gerrieuae/XY-SK60-DPS-enclosure/pictures/DPS_topII.jpg

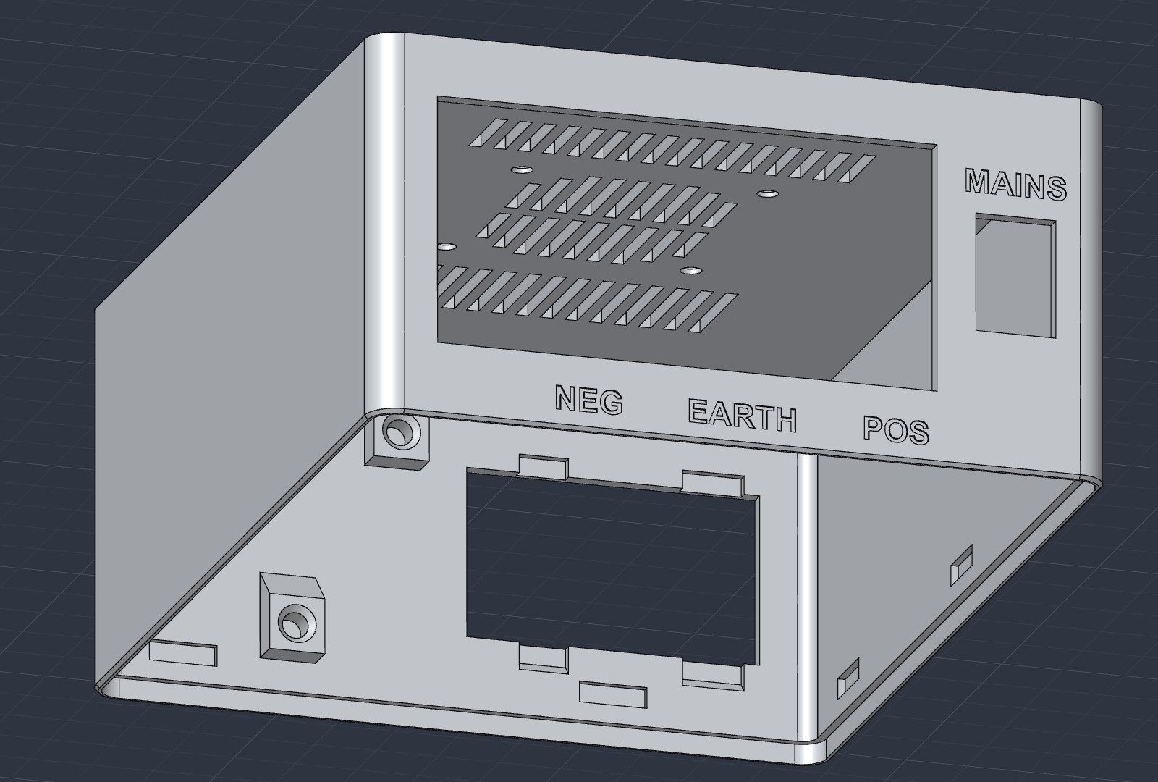
pictures/DPS_topII.jpg
