gerrieuae/XY-SK60-DPS-enclosure/Enclosure_Bottom.3mf

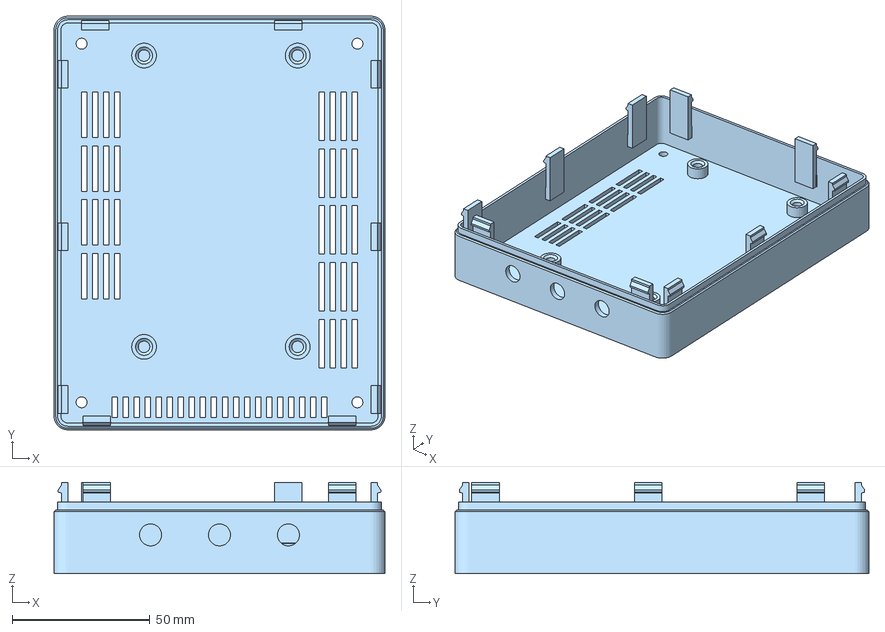
[picture p8: CAD file, 2026-11-08]
Enclosure_Bottom.3mf
120.0 x 150.0 x 33.0 mm
