gerrieuae/XY-SK60-DPS-enclosure/stepFiles/IEC-C14_17362.stp

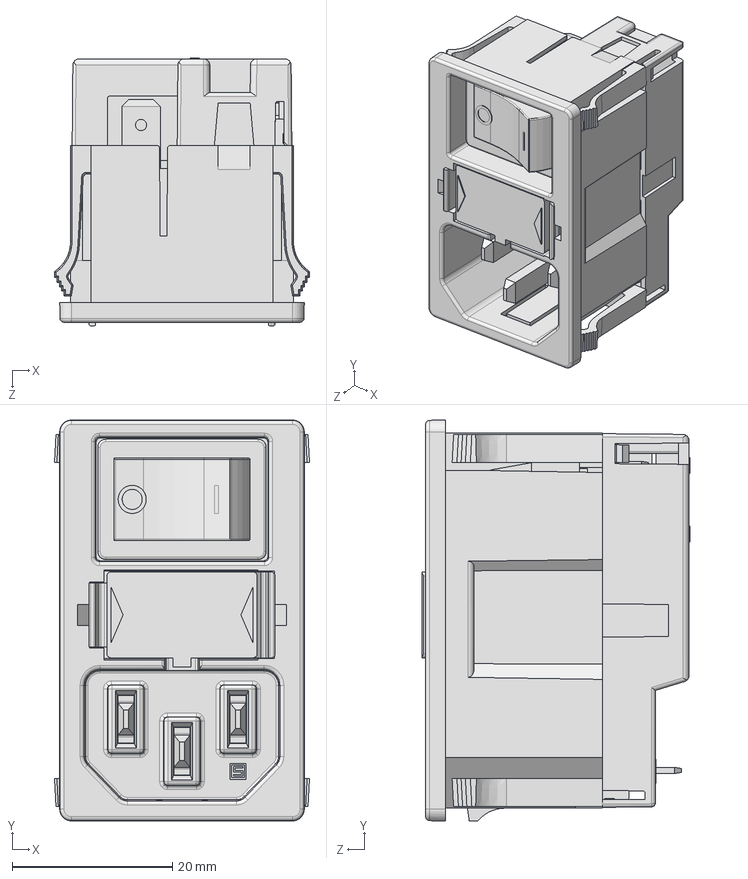
[picture p9: CAD file, 2026-11-04]
stepFiles/IEC-C14_17362.stp
31.8 x 50.0 x 33.4 mm
