gerrieuae/XY-SK60-DPS-enclosure/clipTest_Top.3mf

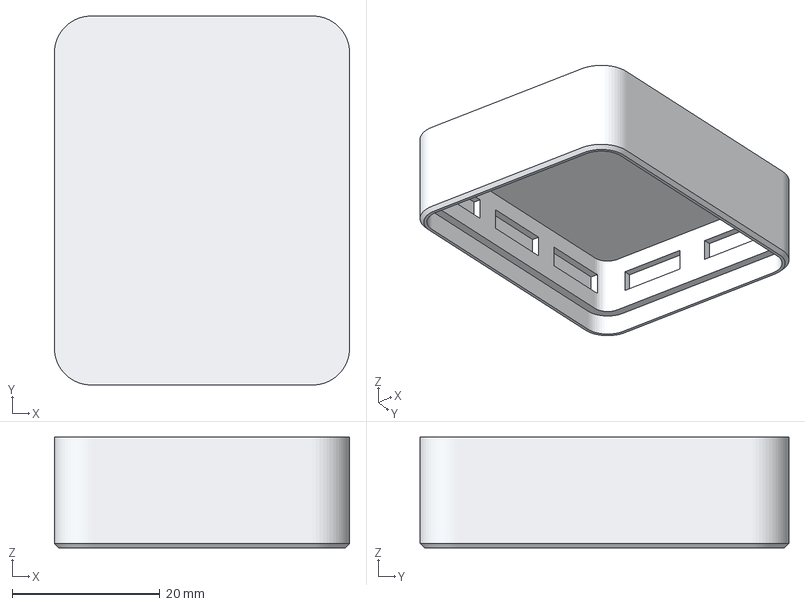
[picture p10: CAD file, 2026-11-08]
clipTest_Top.3mf
40.0 x 50.0 x 15.0 mm
