gerrieuae/XY-SK60-DPS-enclosure/clipTest_Bottom.3mf

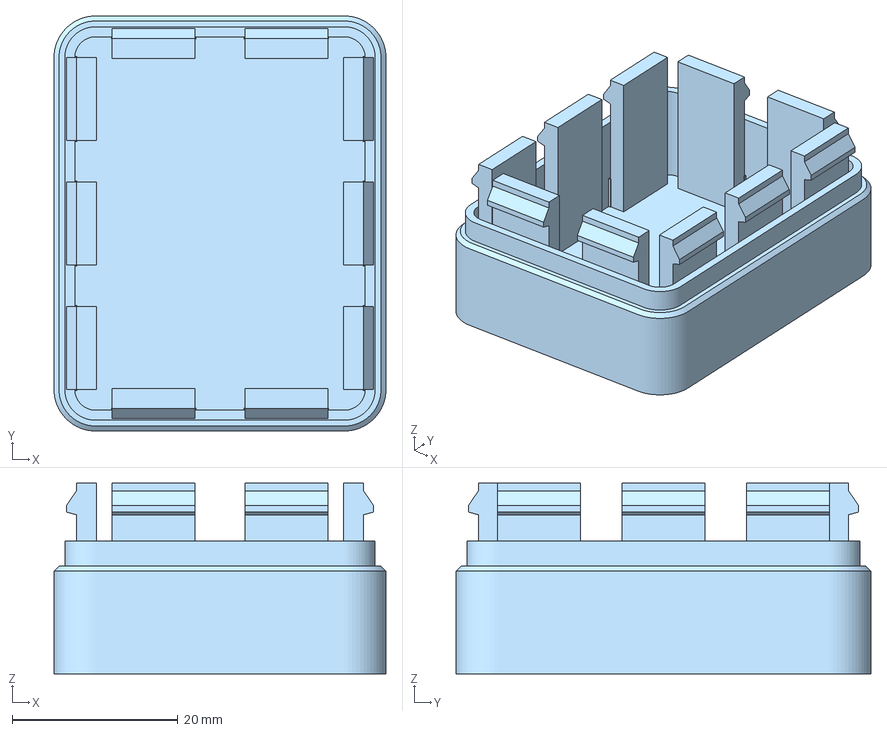
[picture p11: CAD file, 2026-11-08]
clipTest_Bottom.3mf
40.0 x 50.0 x 23.0 mm
