gerrieuae/XY-SK60-DPS-enclosure/stepFiles/IEC-C14_3521819.stp

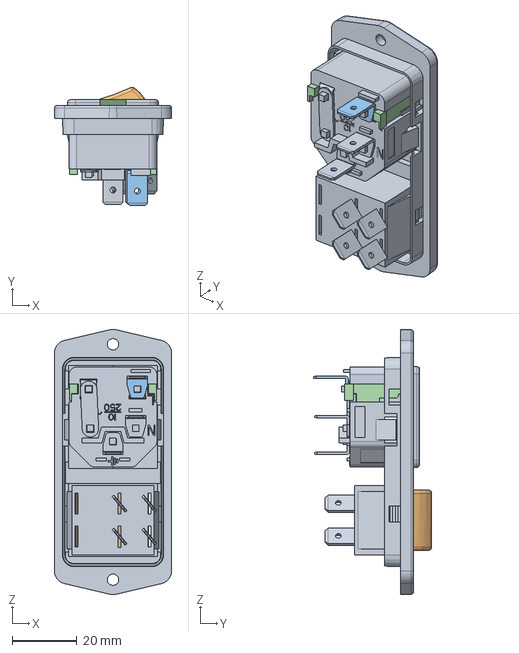
[picture p12: CAD file, 2026-11-04]
stepFiles/IEC-C14_3521819.stp
36.1 x 36.5 x 81.6 mm
