gerrieuae/XY-SK60-DPS-enclosure/Enclosure_Top.3mf

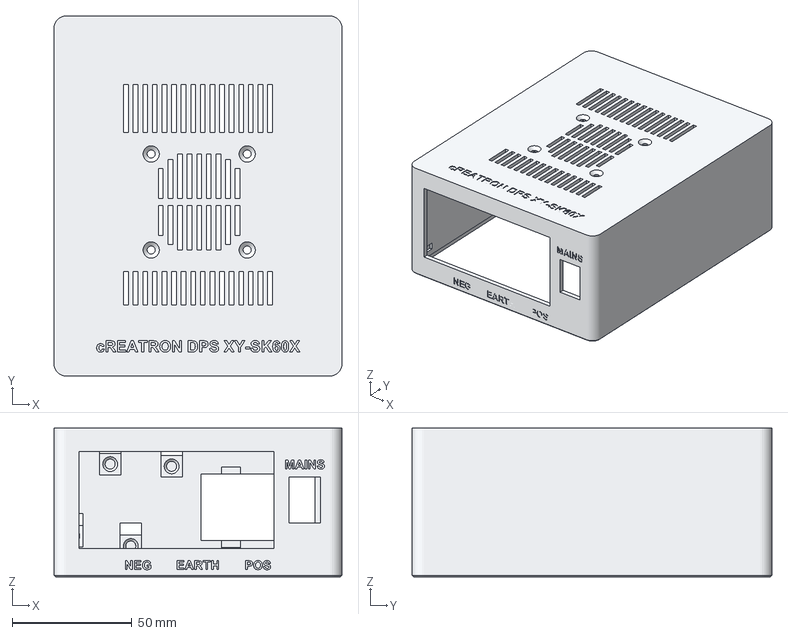
[picture p13: CAD file, 2026-11-08]
Enclosure_Top.3mf
120.0 x 150.0 x 62.0 mm
