gerrieuae/XY-SK60-DPS-enclosure/stepFiles/DC5010_7.stp

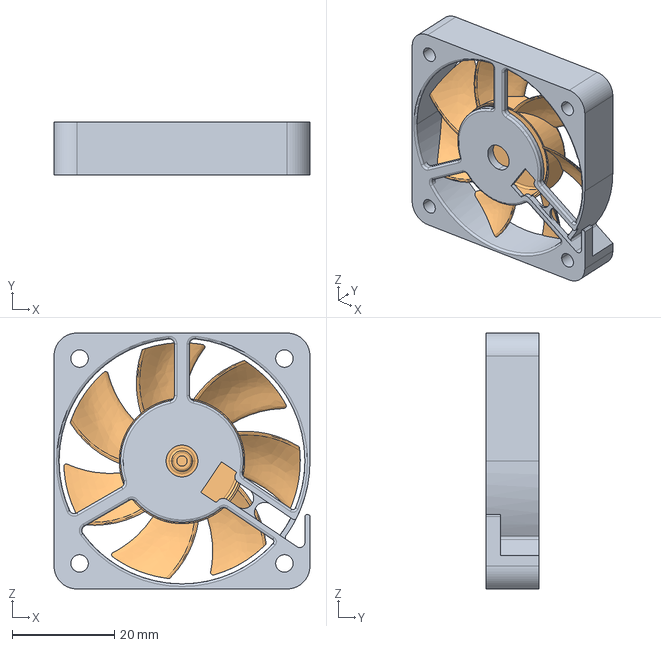
[picture p14: CAD file, 2026-11-01]
stepFiles/DC5010_7.stp
50.0 x 10.4 x 50.0 mm
DC5010-HUO-20211027_4
DC5010-7IPM-20211027_1
