gerrieuae/XY-SK60-DPS-enclosure/insertTest.3mf

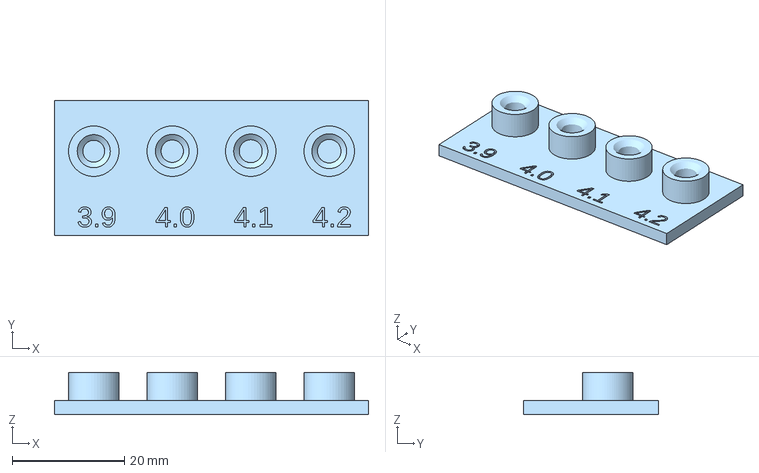
[picture p15: CAD file, 2026-11-08]
insertTest.3mf
56.0 x 24.0 x 7.50 mm
