gerrieuae/XY-SK60-DPS-enclosure/stepFiles/banana_4mm_black-ST-351B V1 - BLACK.STEP

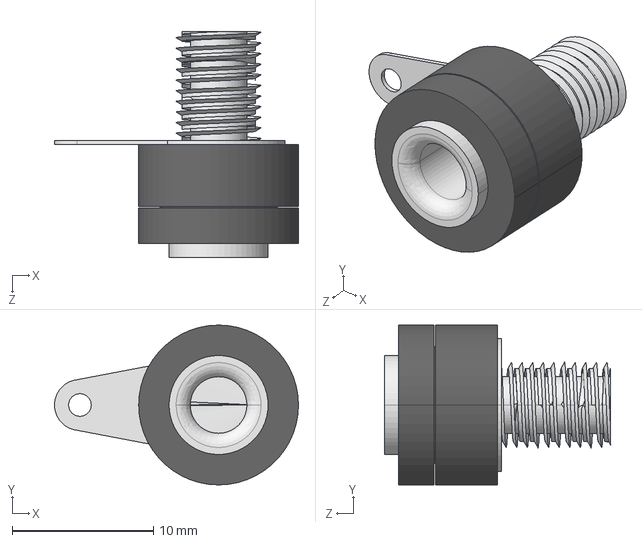
[picture p16: CAD file, 2026-11-01]
stepFiles/banana_4mm_black-ST-351B V1 - BLACK.STEP
17.2 x 11.3 x 16.0 mm
Insulator
Metal
