gerrieuae/XY-SK60-DPS-enclosure/stepFiles/LM2596_DC-DC_CONVERTER.STEP

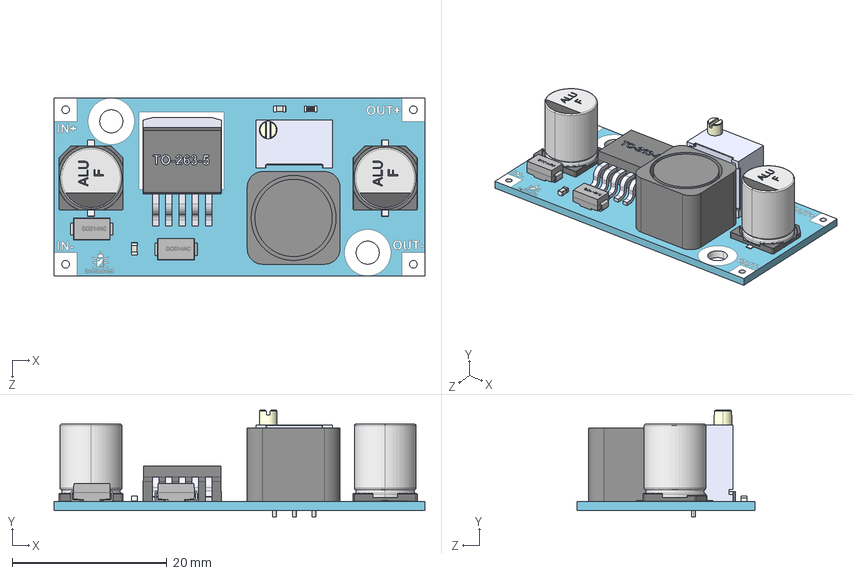
[picture p17: CAD file, 2026-11-01]
stepFiles/LM2596_DC-DC_CONVERTER.STEP
48.0 x 13.8 x 23.0 mm
User Library-DC-DC MODULE LM2596s_User Library-TO-263-5_TO-263-5_Body_1
User Library-DC-DC MODULE LM2596s_User Library-TO-263-5_TO-263-5_Leads_1
User Library-DC-DC MODULE LM2596s_User Library-TO-263-5_TO-263-5_Marking_1
User Library-DC-DC MODULE LM2596s_C0603 x 2
User Library-DC-DC MODULE LM2596s_User Library-ALU-F_Pins_1 x 2
User Library-DC-DC MODULE LM2596s_User Library-ALU-F_Fuss_1 x 2
User Library-DC-DC MODULE LM2596s_User Library-ALU-F_K_X_F6rper_1 x 2
User Library-DC-DC MODULE LM2596s_User Library-ALU-F_Beschriftung_1 x 2
User Library-DC-DC MODULE LM2596s_R0603
BASE_LM2596
INDUCTOR_LM2596
POT_LM2596
DIODE_LM2596 x 2
