gerrieuae/XY-SK60-DPS-enclosure/(commit log)

2026-11-01 Initial commit: 36 V bench PSU enclosure (110 x 150 x 85)
    SolidCraft design of a 3D-printed two-part enclosure for an AC-DC2416
    36 V supply with XY-SK60 controller, Schurter C14 inlet, front mains
    rocker, ST-351B banana sockets and a 5 V fan on an LM2596HV.
    Includes component models, print-ready 3MF halves, spec.md and README.
    [DC5010_7.stp, Enclosure_Bottom.3mf, Enclosure_Top.3mf, LM2596_DC-DC_CONVERTER.STEP, banana_4mm_black-ST-351B V1 - BLACK.STEP, try1.step]
2026-11-01 Add 120 x 150 x 85 design, 15x21 rocker, and pre-parametric backup
    - PSU_Enclosure_120x85.sc: current main design (IEC cutout 48.1 x 28.1)
    - Rocker_Switch_15x21.sc: measured rocker switch model
    - backup/: snapshot of the 120x85 design before the parametric rework
    - README/spec updated for the 120 mm wide layout
2026-11-01 Make the enclosure parametric (v3.1), geometry unchanged at 120 x 150 x 85
    - Split on a construction plane at split_z; lip and groove sketches
    fully dimensioned from enc_w, enc_d, wall, corner_r, lip_t, lip_clr
    - Bosses replaced by expression-placed standoff cylinders (psu_*, lm_*)
    - Feet, fan screws, all six vent fields, six clips with hooks and
    pockets derived from enc_w, enc_d, split_z, wall and the fan
    - 52 new user parameters, defaults reproduce the previous geometry
    (both enclosure bodies measure identical to backup/)
    - spec.md section 7 rewritten: parameter groups and what still does
    not follow a size change (imported component placement)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
2026-11-01 Derive side floor vent counts from the PSU standoff clearance
    fv_right_n and fv_left_n (replacing fv_side_n) count the slots that fit
    between the outer wall and the PSU standoff plus fv_side_clear, so the
    side vent fields shrink with enc_w instead of running into the posts.
    4 per side at 120 wide, unchanged geometry.
2026-11-01 Rebuild lip and groove from two splits so every size rebuilds
    The lip was an extruded ring joined onto the bottom half with faces
    lying exactly on the cavity wall; that union failed at widths 100-110
    and depth 135 depending on unrelated features. Now the box is split at
    split_z + lip_h (Lip_Top_Plane) and at split_z (Split_Plane); the ring
    between them is trimmed to the lip and joined to the bottom, a copy is
    trimmed to the outer wall and joined to the top after the groove cut.
    All booleans meet a face exactly or cut inside material.
    Verified: no feature errors at the defaults and at W 100/105/110/140,
    D 120/135/180, H 70/110, split 20/28, wall 2/3, corner 4/7. Default
    bodies within 2 mm3 o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
2026-11-01 Square gusseted LM2596 posts and a recessed name on the lid
    - LM2596 posts are now 6 x 6 square, 5 long, with a 45 degree gusset
    on the lid side running 5 mm up the rear wall, so the top prints
    lid-down without support (lm_boss_d renamed lm_boss_w)
    - "cREATRON DPS XY-SK60X" in Arial Bold, 4.7 mm capitals, centred,
    baseline 10 mm behind the front wall, recessed 0.3 mm into the lid
    (name_text, name_h, name_front, name_depth, name_y)
    - No feature errors; rebuilds at width 110 and depth 135 verified
2026-11-01 Swap red and green sockets; NEG / EARTH / POS and MAINS labels on the front
    - Sockets now read black, green, red (NEG, EARTH, POS) left to right
    - Labels in Arial Bold 4.7 mm, recessed 0.3 mm into the front of the
    top half: socket labels centred over each socket with baseline at
    Z 26 (above the seam, below the display bezel), MAINS centred above
    the rocker at Z 68 (label_* and mains_z parameters)
    - Front label sketch sits on the flipped XZ plane so the text reads
    from the front; 101 features, no errors
2026-11-01 Centre the socket row on the box at 25 mm pitch
    ban_x (0) and ban_pitch (25, was 19 about the display centre) now
    place the three socket cut-outs and the NEG / EARTH / POS labels; the
    socket components were moved to (-25, 0, 25). No interference with
    the PSU or keep-outs; 101 features, no errors.
2026-11-01 Re-pick the top seam chamfer edges on the current topology
    Clears the "edge no longer exists" warning left from the lip rework;
    same geometry.
2026-11-01 Clip roots 0.1 mm larger than the arms; top half opaque again
    The arms' side and bottom faces lay exactly on the roots' faces, which
    made the kernel nudge every arm join (five warnings). The roots now
    extend 0.1 mm beyond the arm on both sides and below. Remaining
    warnings are the two split-plane nudges and the three open-shell
    socket imports. Enclosure_Top appearance back to opacity 1.
2026-11-01 Ignore local working copies of the enclosure design
    The repo history replaces ad-hoc copies and numbered backups, so
    "… copy.sc" and PSU_Enclosure_120x85_backup*.sc stay untracked.
2026-11-02 Rocker switch from the KCD1-101 datasheet; cut-out 19.2 x 13
2026-11-02 Lip ring from box cuts instead of splits; split warnings gone
    Bottom = copy cut above split_z + lip_h, outer wall trimmed above split_z
    (leaves the lip); top = cut below split_z plus the groove. No split or join
    features, seam exactly at Z 23. Sweeps W 100-140, D 120-180, H 70-110,
    split 20-28 all rebuild.
2026-11-02 Re-export Enclosure_Top/Bottom.3mf from the 120 x 150 x 85 design
    [Enclosure_Bottom.3mf, Enclosure_Top.3mf]
2026-11-02 Show the mains rocker switch again
2026-11-02 Show the fan and LM2596 buck module
2026-11-02 Front panel labels at 80 % height (label_h = name_h * 0.8)
    [Enclosure_Top.3mf]
2026-11-02 Banana sockets 2.5 mm further back (Y -72.2)
2026-11-02 Add Sketch1 (projected SK60 case side face, work in progress)
2026-11-04 Add clipTest: small box to test-print the snap clips
    Same wall, lip, groove, seam chamfer and 6 clips as the main design,
    40 x 50 x 28 with the split at Z 13. Includes both halves as 3MF.
    [clipTest_Bottom.3mf, clipTest_Top.3mf]
2026-11-04 Add alternative IEC C14 inlet models and their STEP sources
    [IEC-C14_17361.stp, IEC-C14_17362.stp, IEC-C14_3521819.stp]
2026-11-05 Own banana socket model; no more open-body warnings
    Banana_4mm_Black/Red/Green.sc replace the vendor STEP imports (their metal
    body is an open shell that stitching can't close). Front cap in front of
    the panel, 6 mm nozzle through the 6 mm hole, rear piece behind the
    2.5 mm wall; origin on the outer face (Y -75). The design now rebuilds
    without any warnings.
2026-11-07 Re-export Enclosure_Bottom.3mf
    [Enclosure_Bottom.3mf]
2026-11-07 Move vendor STEP sources from oldTry/ to stepFiles/; docs updated
    [DC5010_7.stp, IEC-C14_17361.stp, IEC-C14_17362.stp, IEC-C14_3521819.stp, LM2596_DC-DC_CONVERTER.STEP, banana_4mm_black-ST-351B V1 - BLACK.STEP]
2026-11-07 Move oldTry/ to backup/oldTry/
    [try1.step]
2026-11-07 Remove backup copies already kept in git history
    [try1.step]
2026-11-07 Add parameters.csv (parameter table of the main design)
    [parameters.csv]
2026-11-07 Measured bananas, PSU turned and moved back, heat-set insert holes, fan countersinks
    - Banana sockets: nozzle and rear bore 7.5 (measured), metal 14 mm inside
    (in_len); panel holes ban_hole_d 6 -> 8
    - PSU turned 180 deg (AC terminal under the IEC inlet, DC terminal at the
    front) and moved 13 mm back (psu_y 7.9)
    - AC-DC2416.sc: DC wiring keep-out 12 mm (dc_wire_clear)
    - PSU standoffs 9 mm and LM2596 posts 9 x 9 with 4 x 5 mm holes and 1 mm
    lead-in chamfers for M3 heat-set inserts (5 OD x 4)
    - Fan screw holes countersunk 6.8 x 90 deg for M3 countersunk screws;
    grille slots end inside the fan circle
    - All component links point to the project folder; 3MFs re-exported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
    [Enclosure_Bottom.3mf, Enclosure_Top.3mf, parameters.csv]
2026-11-08 Insert test: four standoffs with 3.9-4.2 mm holes for the M3 heat-set inserts
    [insertTest.3mf]
2026-11-08 Insert holes 4.2 mm (tested best); README pictures
    [Enclosure_Bottom.3mf, Enclosure_Top.3mf, parameters.csv]
2026-11-08 Pictures of the clip test box and the insert test in README and spec
2026-11-08 Stronger, more clips; IEC latch pockets; posts for the small fan buck module
    - Clips: 10 instead of 6, arms 2.4 x 10 mm (about 4x the holding force);
    clip test box updated with the same clips
    - Display cut-out clearance 0.15 mm (was 0.3)
    - IEC inlet: wall thinned to 1.0 mm only at the four latch positions
    (10 and 8 mm wide, scaled from a photo), the rest stays 2.5 mm
    - Posts for the smaller fan buck module (23.5 x 43.5, holes 30 x 15.8)
    beside the original LM2596 posts
    - Re-exported 3MFs and parameters.csv; spec and README updated
    [Enclosure_Bottom.3mf, Enclosure_Top.3mf, clipTest_Bottom.3mf, clipTest_Top.3mf, parameters.csv]
2026-11-09 Updated enclosure pictures; add second top view
